minseokeem/structural-digital-twin-monitoring/server/public/assets/sensor_case_part2.stl

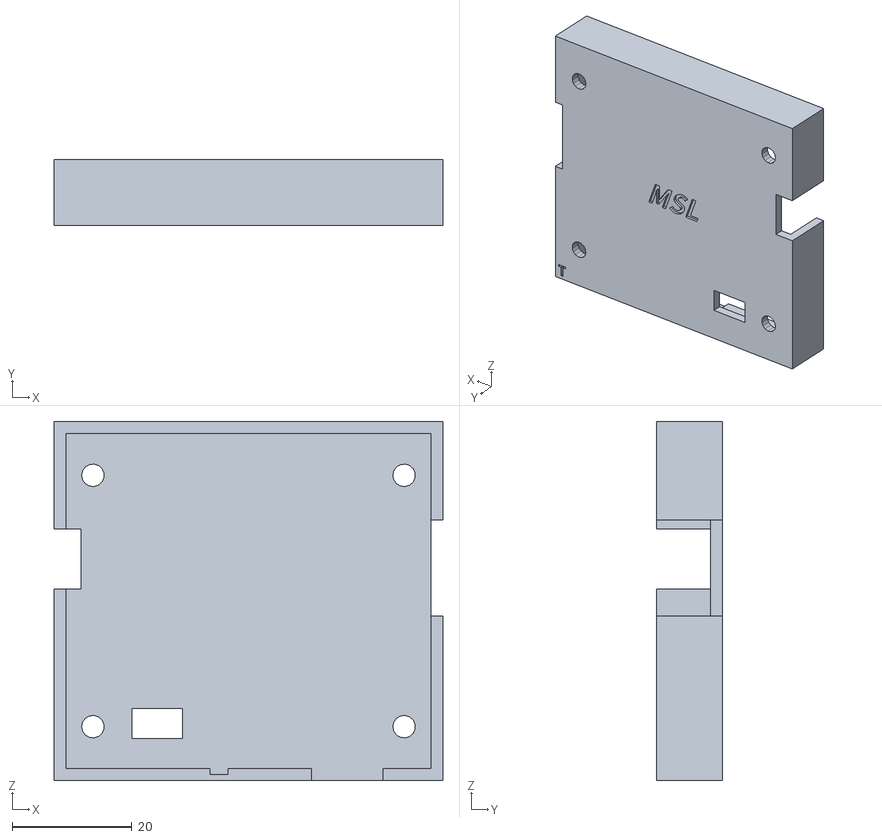
[picture p6: CAD file, 2026-11-04]
server/public/assets/sensor_case_part2.stl
65.0 x 11.0 x 60.0
