minseokeem/structural-digital-twin-monitoring/server/public/demo/01_PLAN.dxf

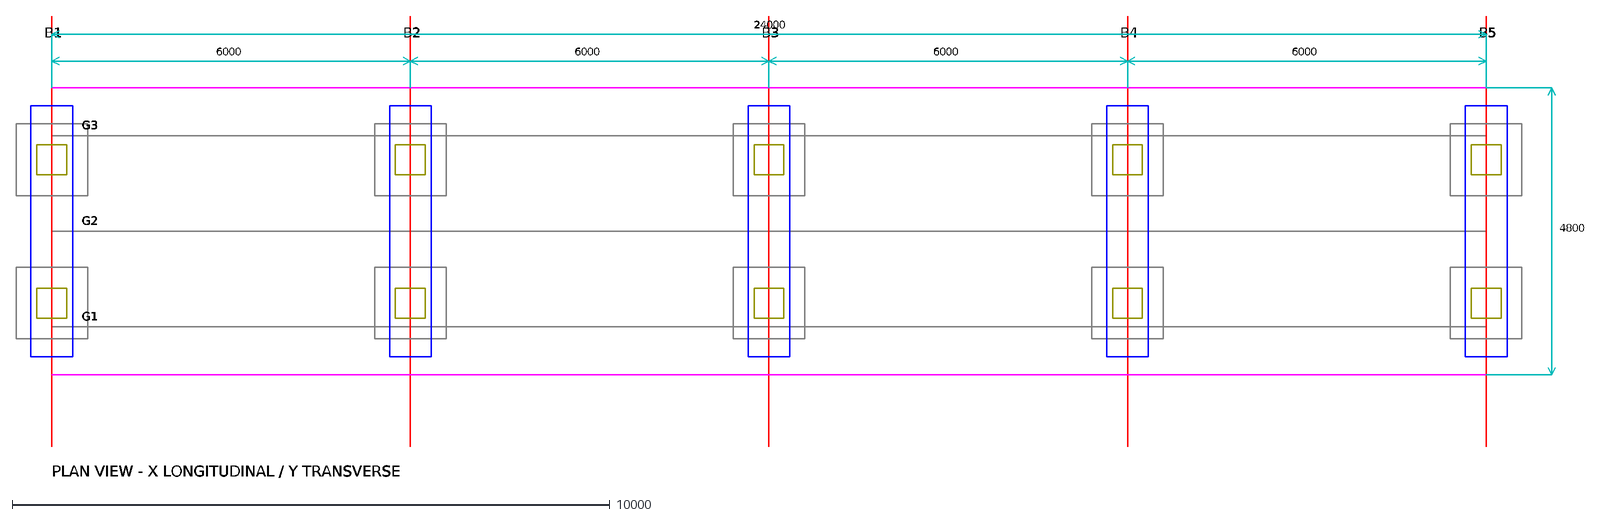
[picture p7: CAD file, 2026-11-04]
server/public/demo/01_PLAN.dxf
B1
B2
B3
B4
B5
G1
G2
G3
24000
6000
4800
PLAN VIEW - X LONGITUDINAL / Y TRANSVERSE
