minseokeem/structural-digital-twin-monitoring/server/public/assets/sensor_case_part1.stl

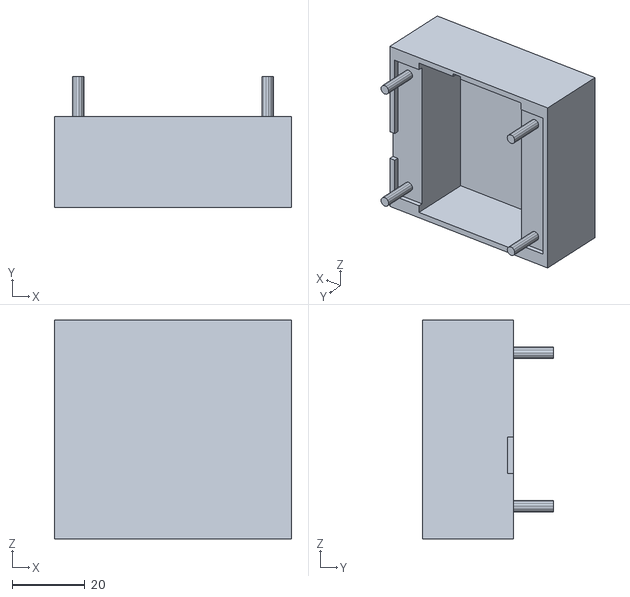
[picture p8: CAD file, 2026-11-04]
server/public/assets/sensor_case_part1.stl
65.0 x 36.0 x 60.0
