minseokeem/structural-digital-twin-monitoring/server/public/demo/02_ELEVATION.dxf

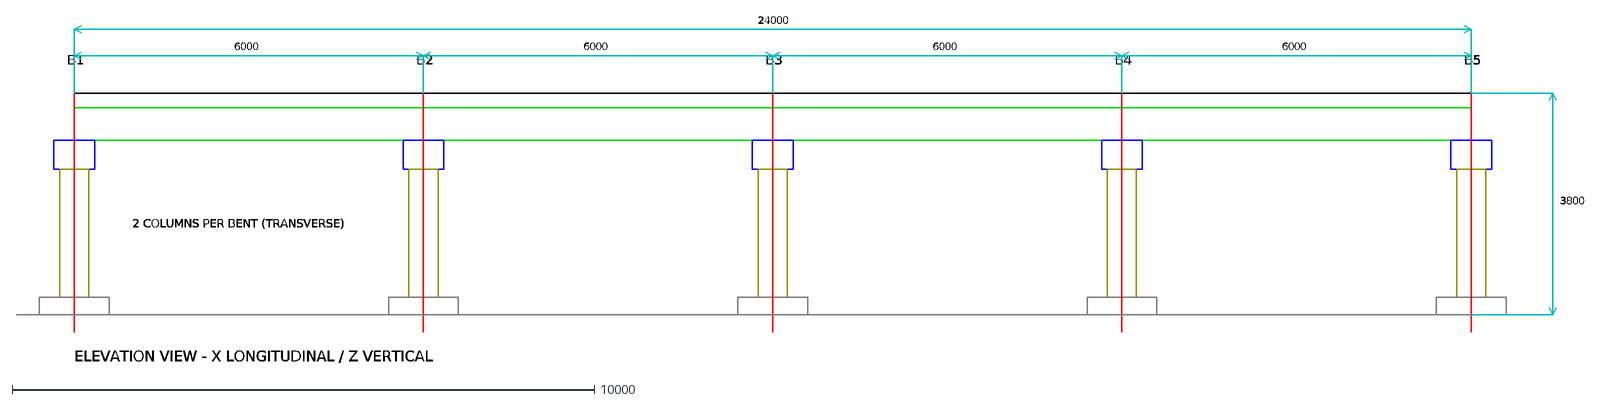
[picture p9: CAD file, 2026-11-04]
server/public/demo/02_ELEVATION.dxf
B1
B2
B3
B4
B5
6000
24000
3800
ELEVATION VIEW - X LONGITUDINAL / Z VERTICAL
2 COLUMNS PER BENT (TRANSVERSE)
