minseokeem/structural-digital-twin-monitoring/server/public/demo/03_SECTION_AA.dxf

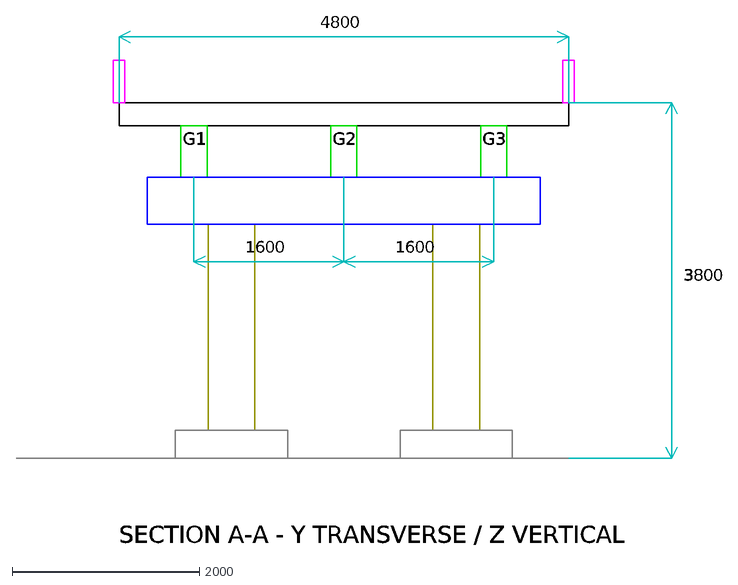
[picture p10: CAD file, 2026-11-04]
server/public/demo/03_SECTION_AA.dxf
4800
3800
1600
SECTION A-A - Y TRANSVERSE / Z VERTICAL
G1
G2
G3
