minseokeem/structural-digital-twin-monitoring/docs/media/field_results.png

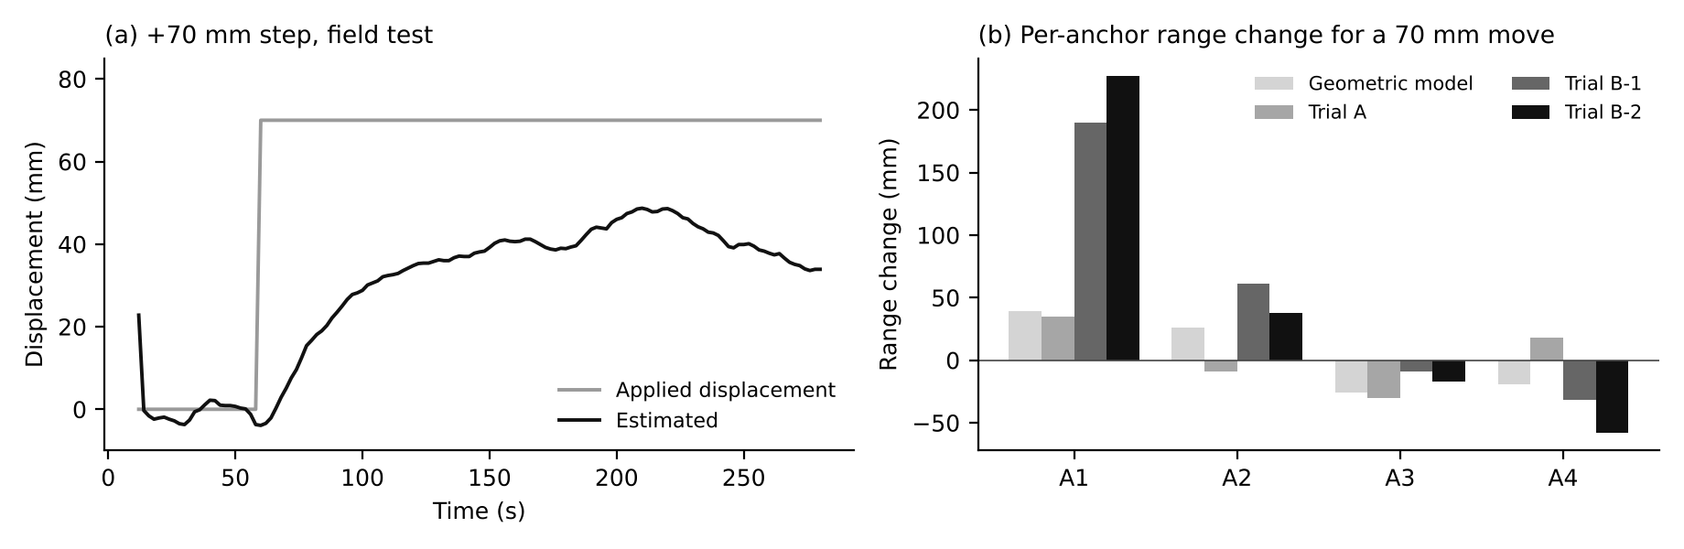
docs/media/field_results.png
