minseokeem/structural-digital-twin-monitoring/firmware/tag/secrets.example.h

// Copy to secrets.h and fill in. secrets.h is git-ignored.
#pragma once
#define WIFI_SSID        "your-ssid"
#define WIFI_PASSWORD    "your-password"
#define SERVER_IP_OCTETS 192, 168, 0, 10   // PC running server/
